idolpx/meatloaf-archived/data/.save/README

Save Folder

Cached Disk Images
Modified Disk Images
Virtual Printer Files
Favorite Sites
Recent Sites
Application Settings
