idolpx/meatloaf-archived/data/.sys/README

System Files

devices.db
file browser programs
device roms
help.txt
