idolpx/meatloaf-archived/data/.sys/help.md

``` ASCII
  ███▄ ▄███▓▓█████ ▄▄▄     ▄▄▄█████▓
 ▓██▒▀█▀ ██▒▓█   ▀▒████▄   ▓  ██▒ 
 ▓██    ▓██░▒███  ▒██  ▀█▄ ▒ ▓██░
 ▒██    ▒██ ▒▓█  ▄░██▄▄▄▄██░ ▓██▓
▒▒██▒   ░██▒░▒████ ▓█   ▓██  ▒██▒
░░ ▒░   ░  ░░░ ▒░  ▒▒   ▓▒█  ▒ ░░
  ██▓    ▒█████   ▄▄▄        █████
▒▓██▒   ▒██▒  ██▒▒████▄    ▓██    
░▒██░   ▒██░  ██▒▒██  ▀█▄  ▒████  
 ▒██░   ▒██   ██░░██▄▄▄▄██ ░▓█▒   
 ░██████░ ████▓▒░ ▓█   ▓██▒░▒█░   
 ░ ▒░▓  ░ ▒░▒░▒░  ▒▒   ▓▒█░ ▒ ░   
 ░ ░ ▒    ░ ▒ ▒░   ░   ▒▒ ░ ░     
   ░ ░  ░ ░ ░ ▒    ░   ▒    ░ ░   
     ░      ░ ░        ░  ░ 
```

# Basic Meatloaf Commands

/mode {modem | shell}
Change command mode
modem = Modem emulation mode
shell = Shell command line mode

/help modem
/help drive
/help printer
/help network
/help device
