idolpx/meatloaf-archived/docs/windows-dev.md

# Windows Dev Environment Setup

1. Install "git" for windows<br/>
	 *It's fine to take all default settings.*<br/>
	 
	 > https://git-scm.com/download/win

2. Open a command prompt and change directory to the folder 
	 where you want to download the Meatloaf firmware.<br/>
	 Enter the following command.
	
	 > git clone https://github.com/idolpx/meatloaf.git
	
	 The firmware source code will be downloaded and put into a sub directory named "meatloaf".
	 Change into the directory and copy the platformio.ini.sample file to platformio.ini.
	
	 > cd meatloaf
	 
	 > copy platformio.ini.sample platformio.ini
	
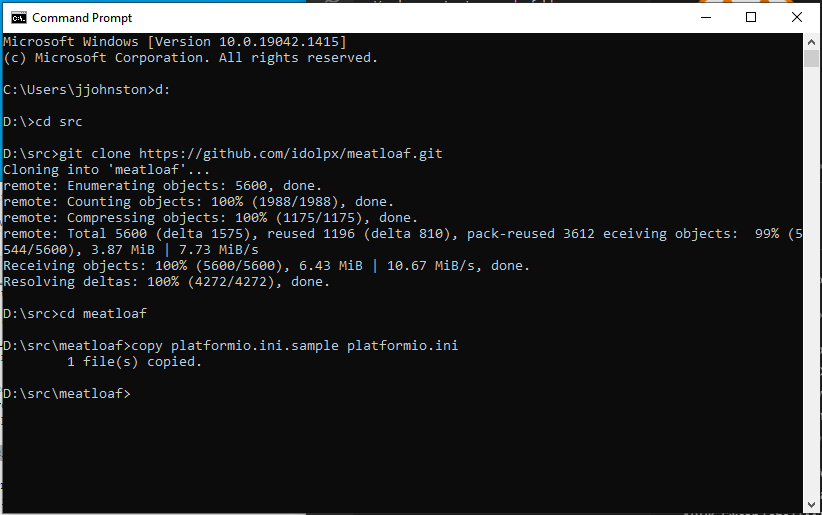
[picture p3: docs/git-meatloaf.png]
git-meatloaf
	
	
3. Install Visual Studio Code<br/>
	 Take default options during setup.<br/>
	 *(I also check off the extra options for adding the 
	 "Open with Code" context menu option for files and folders.)*<br/>
	 
	 > https://code.visualstudio.com/Download
	 
	 Launch VS Code and click on the "Extensions" icon in the side menu.<br/>
	 Search for "Git Graph" and select it and install it.<br/>
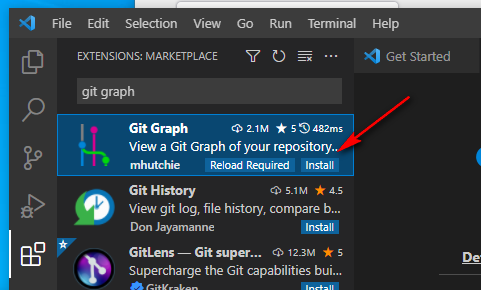
[picture p4: docs/vsc-gitgraph.png]
vsc-gitgraph
	 
	 
	 Search for "PlatformIO" and select it and install it.<br/>
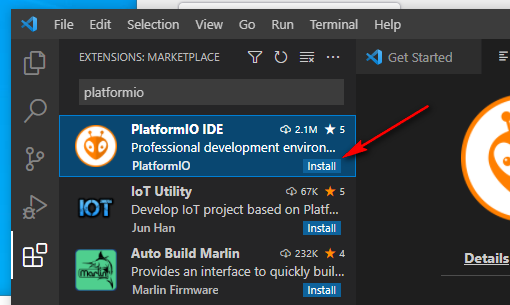
[picture p5: docs/vsc-platformio.png]
vsc-platformio
	 
	
4. Open the Meatloaf folder in VS Code.<br/>
	 Click "File/Open Folder" and browse to select the "meatloaf" folder that was created earlier.
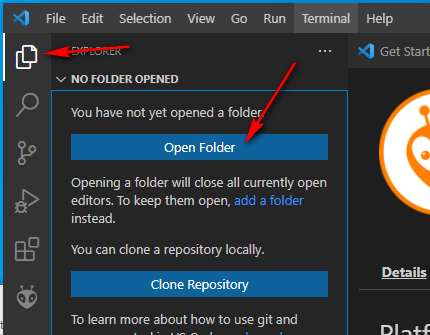
[picture p6: docs/vsc-openfolder.png]
vsc-openfolder
	 
	
5. Edit "platformio.ini" by uncommenting and editing the windows options for upload and monitor port.
	 Comment out the Linux and Mac options if they are not already.
	 Save the file.
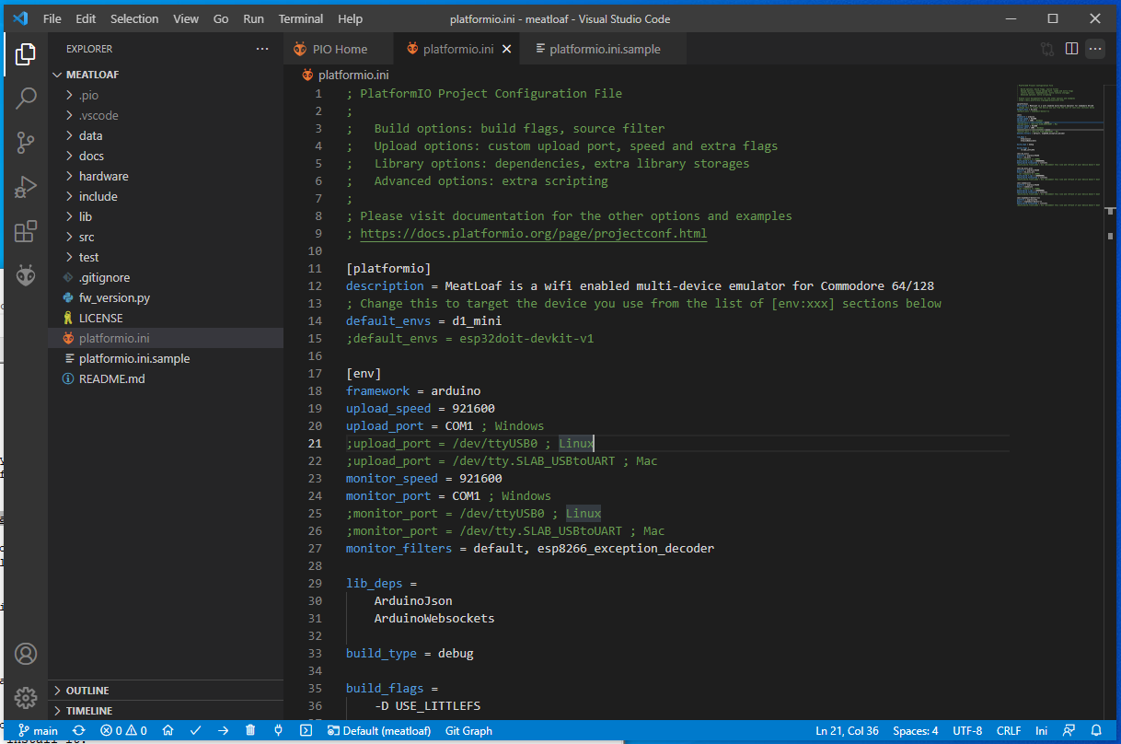
[picture p7: docs/vsc-editini.png]
vsc-editini
	 
	
6. Compile the firmware.<br/>
	 The easiest way to do this is to hit the "check" icon in the status bar.<br/>
	 *(The first time you build it will take a long time. It has to install the platform tools and all dependancies required for the build process.)*<br/>
	 pio-build-1
	 <br/>
	 You can also use the build option under Project Tasks in the PlatformIO icon from the side menu.
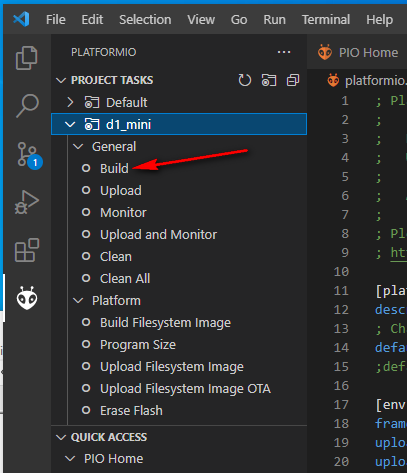
[picture p8: docs/pio-build-2.png]
pio-build-2
	 
	 <br/>
	 Success!!!<br/>
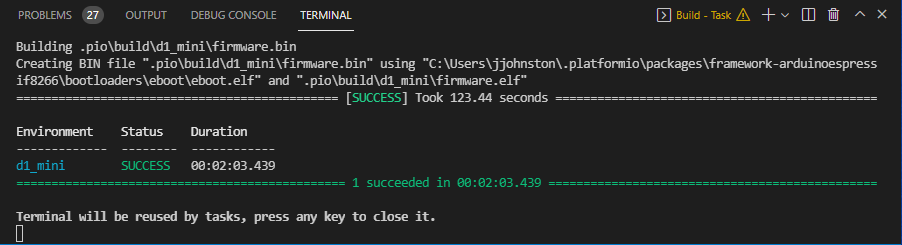
[picture p9: docs/vsc-piobuildsuccess.png]
vsc-piobuildsuccess
	 
	
7. Upload the firmware.<br/>
	 You can use the "right arrow" in the status bar to upload the firmware to your ESP module.
	 The "Upload" option is also available under Project Tasks in the PlatformIO icon from the side menu.
	
8. Build and Upload Filesystem Image<br/>
	 This task is available under Project Tasks in the PlatformIO icon from the side menu.

## Using Git Graph

1. Click the "Source Control" icon from the side menu.
2. Click the "View Git Graph (git log)" button to the right of "SOURCE CONTROL".
	 When viewing the graph you can switch see all commits to all branches of the code.
	 You can right click on a branch label to checkout that branch.<br/>
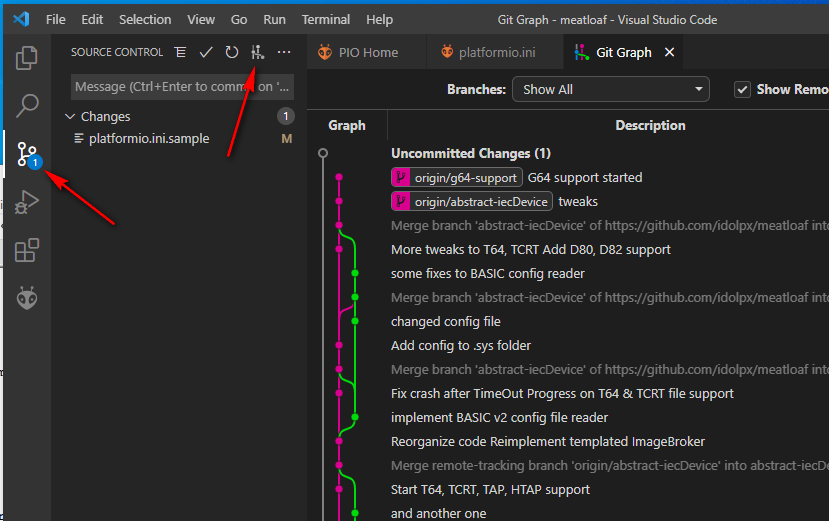
[picture p10: docs/vsc-showgitgraph.png]
vsc-showgitgraph
	 <br/>
	 <br/>
	 You can also switch branches by activating the menu dropdown list by clicking the 
	 current branch label at the far left of the status bar.<br/>
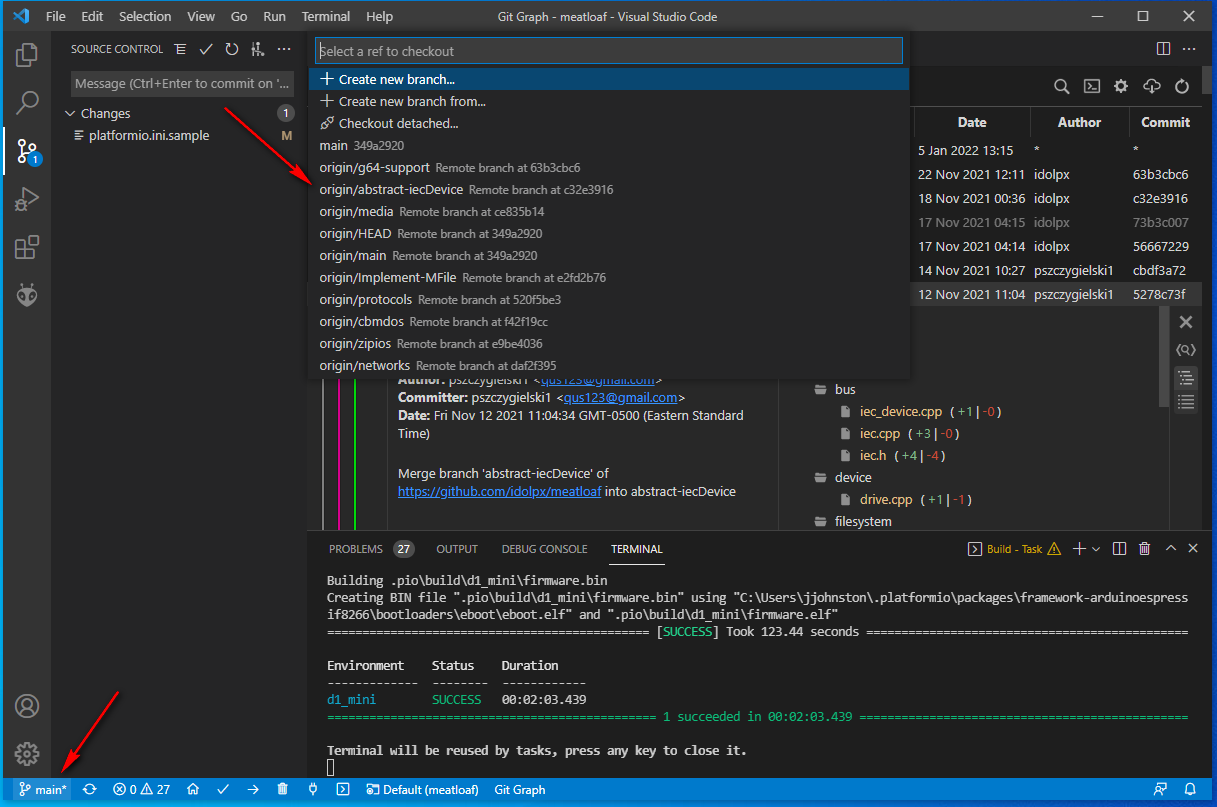
[picture p11: docs/vsc-changebranch.png]
vsc-changebranch
	 <br/>
	 <br/>
	 To switch to a specific commit, right click on a the commit in the graph.
	 Then select "Reset current branch to this Commit..." from the menu.<br/>
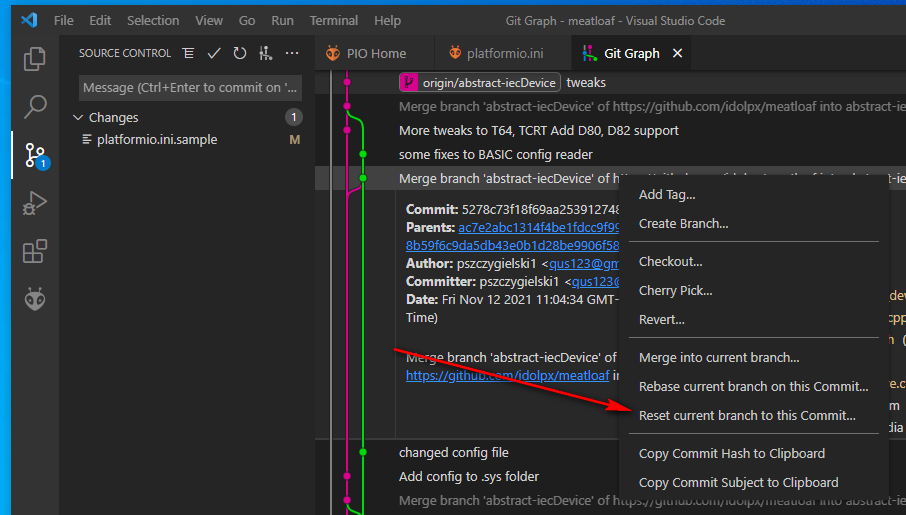
[picture p12: docs/vsc-resettocommit.png]
vsc-resettocommit
	 <br/>
	 <br/>
