idolpx/meatloaf-archived/docs/meatloaf64-svr.png

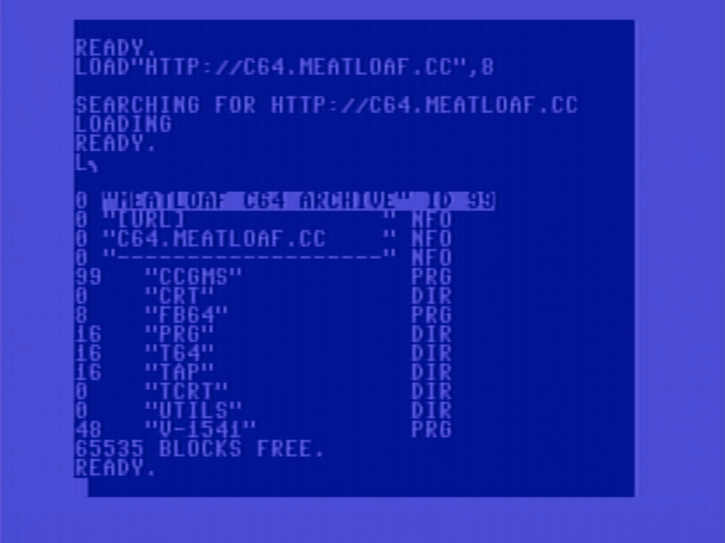
docs/meatloaf64-svr.png
