idolpx/meatloaf-archived/docs/teosweeann-5v.png

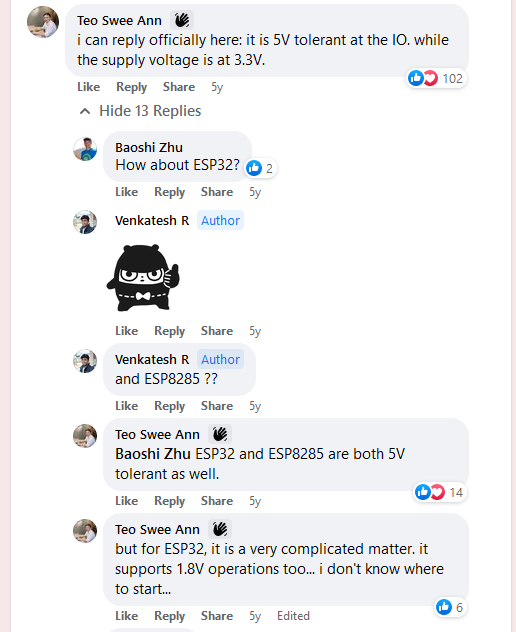
docs/teosweeann-5v.png
