idolpx/meatloaf-archived/docs/teosweeann.png

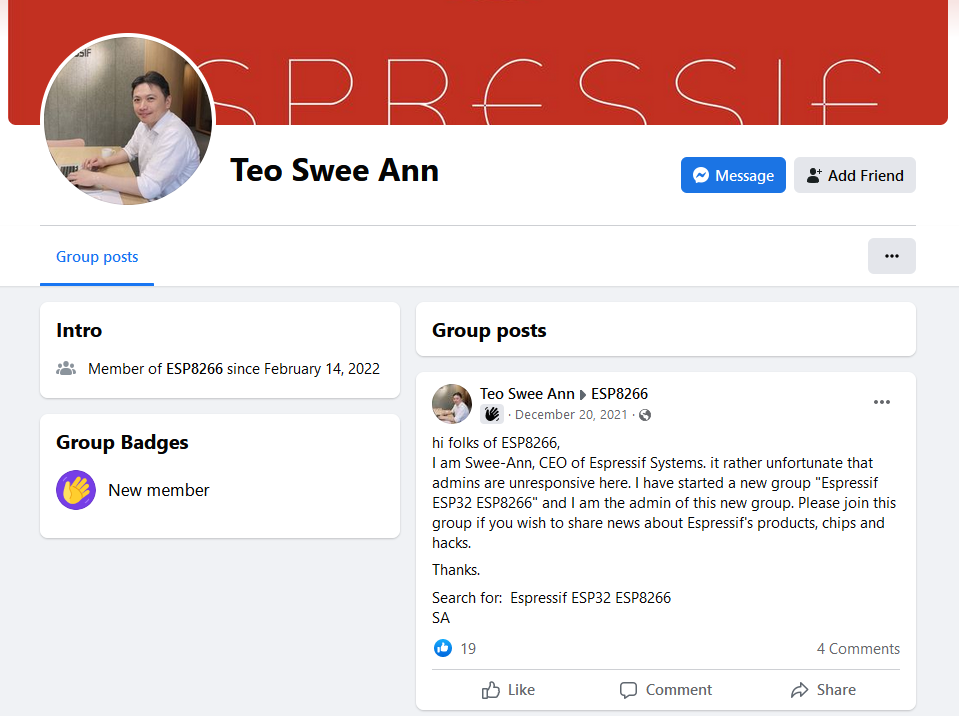
docs/teosweeann.png
