idolpx/meatloaf-archived/docs/vsc-openfolder-2.png

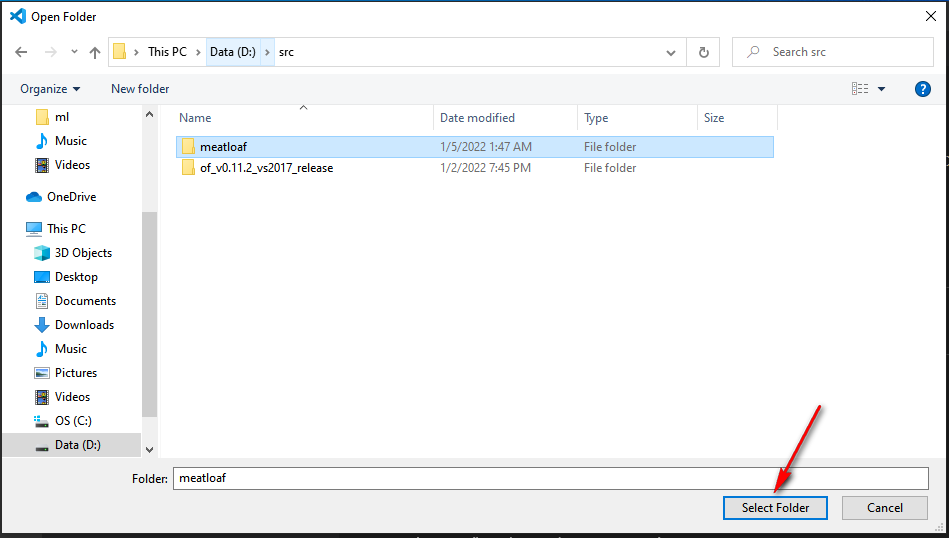
docs/vsc-openfolder-2.png
