idolpx/meatloaf-archived/hardware/meatloaf.drive.modem.1.pdf

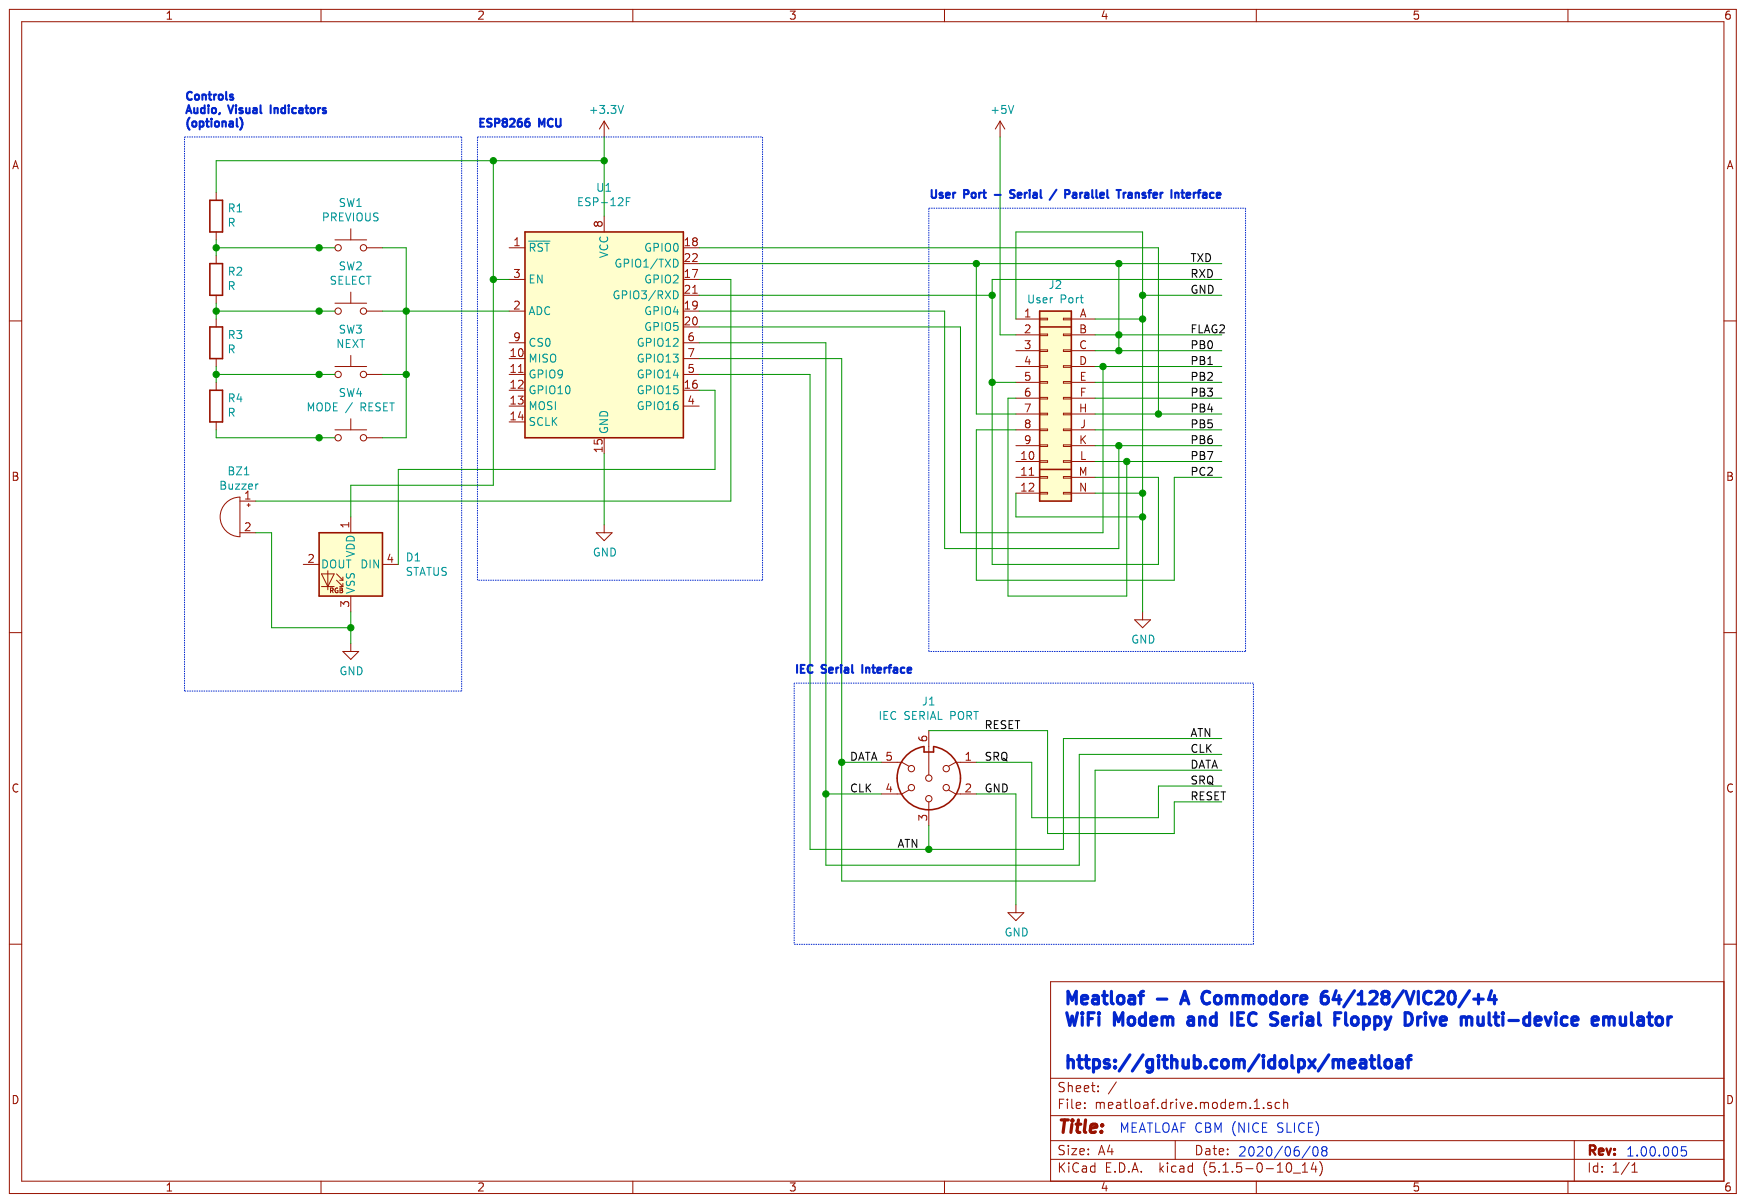
[picture p17: page 1]
