idolpx/meatloaf-archived/hardware/meatloaf.drive.modem.1/meatloaf.drive.modem.1.kicad_sch

## KiCad design hardware/meatloaf.drive.modem.1/meatloaf.drive.modem.1.kicad_sch (2022-02-19)

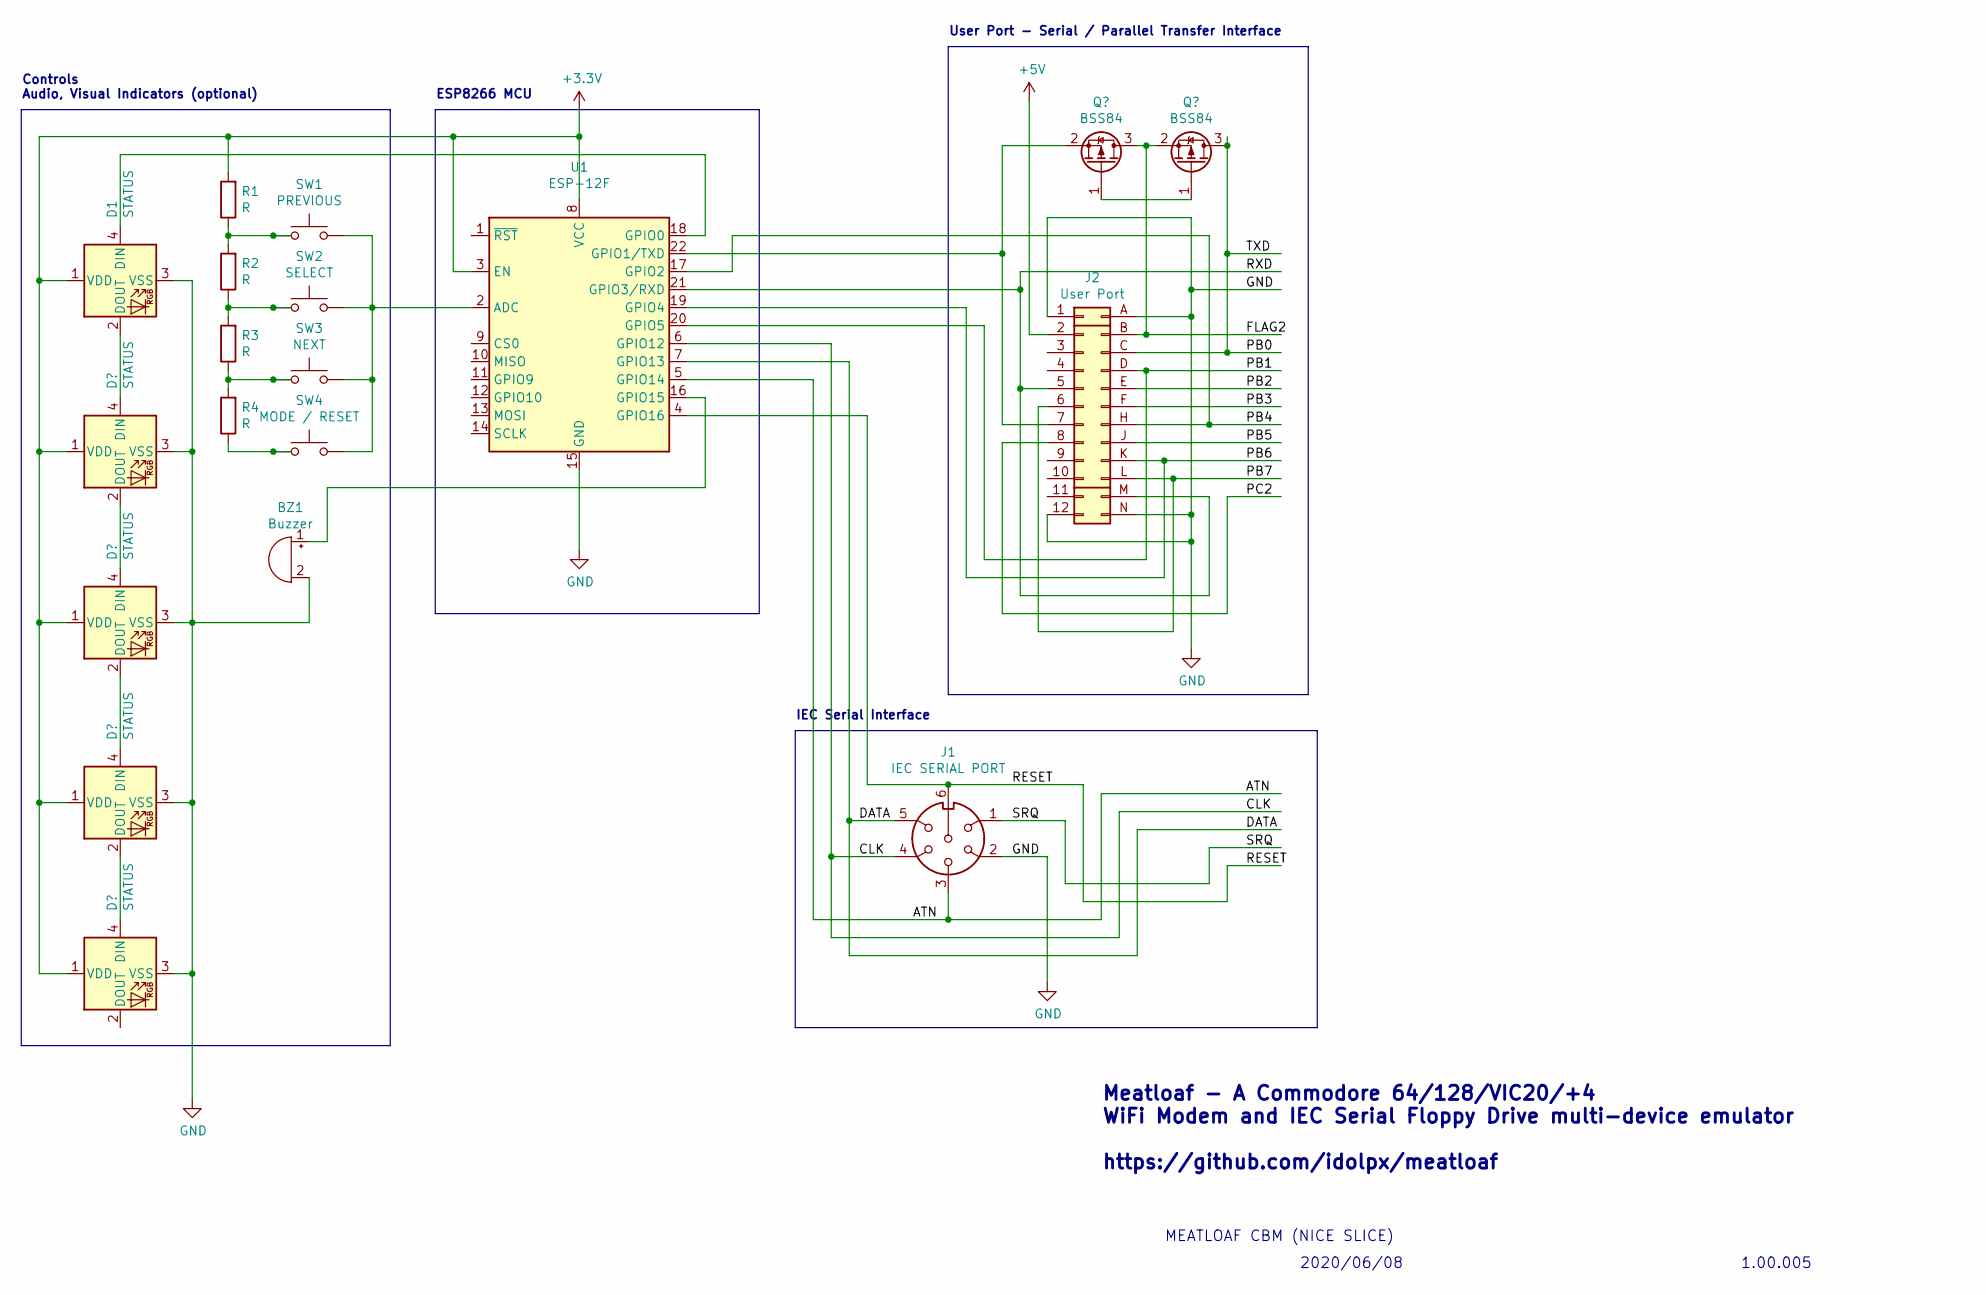
[picture p18: schematic meatloaf.drive.modem.1.kicad_sch]

Parts:
BZ1: Buzzer
D1: STATUS; LED_WS2812B_PLCC4_5.0x5.0mm_P3.2mm
J1: IEC SERIAL PORT
J2: User Port
R1, R2, R3, R4: R
SW1: PREVIOUS
SW2: SELECT
SW3: NEXT
SW4: MODE / RESET
U1: ESP-12F; ESP-12E

Connections:
+3.3V: D1.1 (VDD), R1.2, U1.3 (EN), U1.8 (VCC)
ATN: J1.3, U1.5 (GPIO14)
CLK: J1.4, U1.6 (GPIO12)
DATA: J1.5, U1.7 (GPIO13)
FLAG2: J2.B
GND: BZ1.2 (+), D1.3 (VSS), J1.2, J2.1, J2.12, J2.A, J2.N, U1.15 (GND)
unnamed: BZ1.1 (-), U1.16 (GPIO15)
unnamed: D1.4 (DIN), U1.18 (GPIO0)
unnamed: J2.7, U1.22 (GPIO1/TXD)
unnamed: R1.1, R2.2, SW1.1 (A), SW1.2 (A)
unnamed: R2.1, R3.2, SW2.1 (A), SW2.2 (A)
unnamed: R3.1, R4.2, SW3.1 (A), SW3.2 (A)
unnamed: R4.1, SW4.1 (A), SW4.2 (A)
unnamed: SW1.3 (B), SW1.4 (B), SW2.3 (B), SW2.4 (B), SW3.3 (B), SW3.4 (B), SW4.3 (B), SW4.4 (B), U1.2 (ADC)
PB0: J2.C
PB1: J2.D, U1.20 (GPIO5)
PB2: J2.E
PB3: J2.F
PB4: J2.H, U1.17 (GPIO2)
PB5: J2.J
PB6: J2.K, U1.19 (GPIO4)
PB7: J2.6, J2.L
PC2: J2.8
RESET: J1.6, U1.4 (GPIO16)
RXD: J2.5, J2.M, U1.21 (GPIO3/RXD)
SRQ: J1.1

Notes on the sheet:
1.00.005
Meatloaf - A Commodore 64/128/VIC20/+4 WiFi Modem and IEC Serial Floppy Drive multi-device emulator https://github.com/idolpx/meatloaf
IEC Serial Interface
2020/06/08
ESP8266 MCU
Controls Audio, Visual Indicators (optional)
MEATLOAF CBM (NICE SLICE)
User Port - Serial / Parallel Transfer Interface
