idolpx/meatloaf-archived/src/IECBus/iec.cpp

// Meatloaf - A Commodore 64/128 multi-device emulator
// https://github.com/idolpx/meatloaf
// Copyright(C) 2020 James Johnston
//
// This file is part of Meatloaf but adapted for use in the FujiNet project
// https://github.com/FujiNetWIFI/fujinet-platformio
// 
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
#include "iec.h"

using namespace CBM;

iecBus::iecBus() : m_state(noFlags)
{
} // ctor

// Set all IEC_signal lines in the correct mode for power up state
bool iecBus::init()
{
	// the I/O signaling method used by this low level driver uses two states:
	// PULL state is pin set to GPIO_MODE_OUTPUT with the output driving DIGI_LOW (0V)
	// RELEASE state is pin set to GPIO_MODE_INPUT so it doesn't drive the bus
	// and it allows the C64 pullup to do its job

	// The CLOCK and DATA lines are bidirectional
	// The ATN line is input only for peripherals
	// The SQR line is output only for peripherals

	// set up IO states
	pull(IEC_PIN_ATN);
	pull(IEC_PIN_CLK);
	pull(IEC_PIN_DATA);
	pull(IEC_PIN_SRQ);

//#ifdef RESET_C64
//	release(IEC_PIN_RESET);	// only early C64's could be reset by a slave going high.
//#endif

	// initial pin modes in GPIO
	set_pin_mode(IEC_PIN_ATN, INPUT);
	set_pin_mode(IEC_PIN_CLK, INPUT);
	set_pin_mode(IEC_PIN_DATA, INPUT);	
	set_pin_mode(IEC_PIN_SRQ, INPUT);
#ifdef SPLIT_LINES
	set_pin_mode(IEC_PIN_CLK_IN, INPUT);
	set_pin_mode(IEC_PIN_DATA_IN, INPUT);
#endif

	m_state = noFlags;

	return true;
} // init



// (Jim Butterfield - Compute! July 1983 - "HOW THE VIC/64 SERIAL BUS WORKS")
// STEP 1: READY TO SEND (We are listener now)
// Sooner or later, the talker will want to talk, and send a character. 
// When it's ready to go, it releases the Clock line to false.  This signal change might be 
// translated as "I'm ready to send a character." The listener must detect this and respond, 
// but it doesn't have to do so immediately. The listener will respond  to  the  talker's  
// "ready  to  send"  signal  whenever  it  likes;  it  can  wait  a  long  time.    If  it's  
// a printer chugging out a line of print, or a disk drive with a formatting job in progress, 
// it might holdback for quite a while; there's no time limit. 
uint8_t iecBus::receiveByte(void)
{
	m_state = noFlags;

	// Sample ATN and set flag to indicate SELECT or DATA mode
	if(status(IEC_PIN_ATN) == pulled)
		m_state or_eq atnFlag;

	// Talker ready to send
	if (timeoutWait(IEC_PIN_CLK, released))
	{
		Debug_println("receiveByte: talker ready to send");
		return -1;
	}

	// STEP 2: READY FOR DATA (We are listener now)
	// When  the  listener  is  ready  to  listen,  it  releases  the  Data  
	// line  to  false.    Suppose  there  is  more  than one listener.  The Data line will go false 
	// only when all listeners have released it - in other words, when  all  listeners  are  ready  
	// to  accept  data.  What  happens  next  is  variable.     
	release(IEC_PIN_DATA);

	// Wait for other listeners to be ready
	if (timeoutWait(IEC_PIN_DATA, released))
	{
		Debug_println("receiveByte: wait for all listeners to be ready");
		return -1;
	}

	// Either  the  talker  will pull the 
	// Clock line back to true in less than 200 microseconds - usually within 60 microseconds - or it  
	// will  do  nothing.    The  listener  should  be  watching,  and  if  200  microseconds  pass  
	// without  the Clock line going to true, it has a special task to perform: note EOI.
	uint8_t n = 0;
	while ((status(IEC_PIN_CLK) == released) && (n < 20))
	{
		delayMicroseconds(10);  // this loop should cycle in about 10 us...
		n++;
	}

	if (n >= TIMING_EOI_THRESH)
	{

		// INTERMISSION: EOI (We are listener now)
		// If the Ready for Data signal isn't acknowledged by the talker within 200 microseconds, the 
		// listener knows  that  the  talker  is  trying  to  signal  EOI.    EOI,  which  formally  
		// stands  for  "End  of  Indicator," means  "this  character  will  be  the  last  one."    
		// If  it's  a  sequential  disk  file,  don't  ask  for  more:  there will be no more.  If it's 
		// a relative record, that's the end of the record.  The character itself will still be coming, but 
		// the listener should note: here comes the last character. So if the listener sees the 200 microsecond  
		// time-out,  it  must  signal  "OK,  I  noticed  the  EOI"  back  to  the  talker,    I  does  this  
		// by pulling  the  Data  line  true  for  at  least  60  microseconds,  and  then  releasing  it.  
		// The  talker  will  then revert to transmitting the character in the usual way; within 60 microseconds 
		// it will pull the Clock line  true,  and  transmission  will  continue.  At  this point,  the  Clock  
		// line  is  true  whether  or  not  we have gone through the EOI sequence; we're back to a common 
		// transmission sequence.

		m_state or_eq eoiFlag; // or_eq, |=

		// Acknowledge by pull down data more than 60 us
		pull(IEC_PIN_DATA);
		delayMicroseconds(TIMING_BIT);
		release(IEC_PIN_DATA);

		// talker should pull clock in response
		if (timeoutWait(IEC_PIN_CLK, pulled))
		{
			Debug_println("receiveByte: talker should pull clk to continue EOI");
			return -1;
		}
			
	}

	// STEP 3: SENDING THE BITS (We are listener now)
	// The talker has eight bits to send.  They will go out without handshake; in other words, 
	// the listener had better be there to catch them, since the talker won't wait to hear from the listener.  At this 
	// point, the talker controls both lines, Clock and Data.  At the beginning of the sequence, it is holding the 
	// Clock true, while the Data line is released to false.  the Data line will change soon, since we'll send the data 
	// over it. The eights bits will go out from the character one at a time, with the least significant bit going first.  
	// For example, if the character is the ASCII question mark, which is  written  in  binary  as  00011111,  the  ones  
	// will  go out  first,  followed  by  the  zeros.  Now,  for  each bit, we set the Data line true or false according 
	// to whether the bit is one or zero.  As soon as that's set, the Clock line is released to false, signalling "data ready."  
	// The talker will typically have a bit in  place  and  be  signalling  ready  in  70  microseconds  or  less.  Once  
	// the  talker  has  signalled  "data ready," it will hold the two lines steady for at least 20 microseconds timing needs 
	// to be increased to 60  microseconds  if  the  Commodore  64  is  listening,  since  the  64's  video  chip  may  
	// interrupt  the processor for 42 microseconds at a time, and without the extra wait the 64 might completely miss a 
	// bit. The listener plays a passive role here; it sends nothing, and just watches.  As soon as it sees the Clock line 
	// false, it grabs the bit from the Data line and puts it away.  It then waits for the clock line to go true, in order 
	// to prepare for the next bit. When the talker figures the data has been held for a sufficient  length  of  time,  it  
	// pulls  the  Clock  line true  and  releases  the  Data  line  to  false.    Then  it starts to prepare the next bit.

	// Get the bits, sampling on clock rising edge, logic 0,0V to logic 1,5V:
#if defined(ESP8266)
	ESP.wdtFeed();
#endif
	uint8_t data = 0;
	set_pin_mode(IEC_PIN_DATA, INPUT);
	for (n = 0; n < 8; n++)
	{
		data >>= 1;

		// wait for bit to be ready to read
		if (timeoutWait(IEC_PIN_CLK, released)) // look for rising edge
		{
			Debug_println("receiveByte: wait for ready to read");
			return -1;
		}

		// get bit
		data or_eq (get_bit(IEC_PIN_DATA) ? (1 << 7) : 0); // read bit and shift in LSB first

		// wait for talker to finish sending bit
		if (timeoutWait(IEC_PIN_CLK, pulled)) // wait for falling edge
		{
			Debug_printf("receiveByte: wait for talker to finish sending (%d) bit [%d] (CLOCK)\r\n", n, data);
			return -1;
		}
	}
	delayMicroseconds(TIMING_BIT);

	// STEP 4: FRAME HANDSHAKE (We are listener now)
	// After the eighth bit has been sent, it's the listener's turn to acknowledge.  At this moment, the Clock line  is  true  
	// and  the  Data  line  is  false.    The  listener  must  acknowledge  receiving  the  byte  OK  by pulling the Data 
	// line to true. The talker is now watching the Data line.  If the listener doesn't pull the  Data  line  true  within  
	// one  millisecond  -  one  thousand  microseconds  -  it  will  know  that something's wrong and may alarm appropriately.

	// Acknowledge byte received
	pull(IEC_PIN_DATA);

	// STEP 5: START OVER (We are listener now)
	// We're  finished,  and  back  where  we  started.    The  talker  is  holding  the  Clock  line  true,  
	// and  the listener is holding the Data line true. We're ready for step 1; we may send another character - unless EOI has 
	// happened. If EOI was sent or received in this last transmission, both talker and listener "letgo."  After a suitable pause, 
	// the Clock and Data lines are released to false and transmission stops.
	// NOTE: This does not seem to hold true for the listener. Listener remains pulling data after EOI (James Johnston)

	// if(m_state bitand eoiFlag)
	// {
	// 	// EOI Received
	// 	delayMicroseconds(TIMING_STABLE_WAIT);
	// 	release(IEC_PIN_CLK);
	// 	release(IEC_PIN_DATA);
	// }

	return data;
} // receiveByte


// (Jim Butterfield - Compute! July 1983 - "HOW THE VIC/64 SERIAL BUS WORKS")
// STEP 1: READY TO SEND (We are talker now)
// Sooner or later, the talker will want to talk, and send a character. 
// When it's ready to go, it releases the Clock line to false.  This signal change might be 
// translated as "I'm ready to send a character." The listener must detect this and respond, 
// but it doesn't have to do so immediately. The listener will respond  to  the  talker's  
// "ready  to  send"  signal  whenever  it  likes;  it  can  wait  a  long  time.    If  it's  
// a printer chugging out a line of print, or a disk drive with a formatting job in progress, 
// it might holdback for quite a while; there's no time limit. 
bool iecBus::sendByte(uint8_t data, bool signalEOI)
{
	// Say we're ready
	release(IEC_PIN_CLK);

	// Wait for listener to be ready
	// STEP 2: READY FOR DATA (We are talker now)
	// When  the  listener  is  ready  to  listen,  it  releases  the  Data  
	// line  to  false.    Suppose  there  is  more  than one listener.  The Data line will go false 
	// only when all listeners have released it - in other words, when  all  listeners  are  ready  
	// to  accept  data.  What  happens  next  is  variable. 
	if (timeoutWait(IEC_PIN_DATA, released))
	{
		Debug_printf("sendByte: wait for listener to be ready\r\n");
		return -1;
	}

	// Either  the  talker  will pull the 
	// Clock line back to true in less than 200 microseconds - usually within 60 microseconds - or it  
	// will  do  nothing.    The  listener  should  be  watching,  and  if  200  microseconds  pass  
	// without  the Clock line going to true, it has a special task to perform: note EOI.
	if (signalEOI == true)
	{
		// INTERMISSION: EOI (We are talker now)
		// If the Ready for Data signal isn't acknowledged by the talker within 200 microseconds, the 
		// listener knows  that  the  talker  is  trying  to  signal  EOI.    EOI,  which  formally  
		// stands  for  "End  of  Indicator," means  "this  character  will  be  the  last  one."    
		// If  it's  a  sequential  disk  file,  don't  ask  for  more:  there will be no more.  If it's 
		// a relative record, that's the end of the record.  The character itself will still be coming, but 
		// the listener should note: here comes the last character. So if the listener sees the 200 microsecond  
		// time-out,  it  must  signal  "OK,  I  noticed  the  EOI"  back  to  the  talker,    I  does  this  
		// by pulling  the  Data  line  true  for  at  least  60  microseconds,  and  then  releasing  it.  
		// The  talker  will  then revert to transmitting the character in the usual way; within 60 microseconds 
		// it will pull the Clock line  true,  and  transmission  will  continue.  At  this point,  the  Clock  
		// line  is  true  whether  or  not  we have gone through the EOI sequence; we're back to a common 
		// transmission sequence.

		// Signal eoi by waiting 200 us
		delayMicroseconds(TIMING_EOI_WAIT);

		// get eoi acknowledge: pull
		if (timeoutWait(IEC_PIN_DATA, pulled))
		{
			Debug_printf("sendByte: wait for listener acknowledge EOI (data pull)\r\n");
			return -1;
		}

		// get eoi acknowledge: release
		if (timeoutWait(IEC_PIN_DATA, released))
		{
			Debug_printf("sendByte: wait for listener acknowledge EOI (data release)\r\n");
			return -1;
		}
	}
	else
	{
		delayMicroseconds(TIMING_NO_EOI);		
	}

	// STEP 3: SENDING THE BITS (We are talker now)
	// The talker has eight bits to send.  They will go out without handshake; in other words, 
	// the listener had better be there to catch them, since the talker won't wait to hear from the listener.  At this 
	// point, the talker controls both lines, Clock and Data.  At the beginning of the sequence, it is holding the 
	// Clock true, while the Data line is released to false.  the Data line will change soon, since we'll sendthe data 
	// over it. The eights bits will go out from the character one at a time, with the least significant bit going first.  
	// For example, if the character is the ASCII question mark, which is  written  in  binary  as  00011111,  the  ones  
	// will  go out  first,  followed  by  the  zeros.  Now,  for  each bit, we set the Data line true or false according 
	// to whether the bit is one or zero.  As soon as that's set, the Clock line is released to false, signalling "data ready."  
	// The talker will typically have a bit in  place  and  be  signalling  ready  in  70  microseconds  or  less.  Once  
	// the  talker  has  signalled  "data ready," it will hold the two lines steady for at least 20 microseconds timing needs 
	// to be increased to 60  microseconds  if  the  Commodore  64  is  listening,  since  the  64's  video  chip  may  
	// interrupt  the processor for 42 microseconds at a time, and without the extra wait the 64 might completely miss a 
	// bit. The listener plays a passive role here; it sends nothing, and just watches.  As soon as it sees the Clock line 
	// false, it grabs the bit from the Data line and puts it away.  It then waits for the clock line to go true, in order 
	// to prepare for the next bit. When the talker figures the data has been held for a sufficient  length  of  time,  it  
	// pulls  the  Clock  line true  and  releases  the  Data  line  to  false.    Then  it starts to prepare the next bit.
	// NOTE: delay between bits needs to be 75us minimum from my observations (James Johnston)

	// Send the bits, sampling on clock rising edge, logic 0,0V to logic 1,5V:
#if defined(ESP8266)
	ESP.wdtFeed();
#endif	
	set_pin_mode(IEC_PIN_DATA, OUTPUT);
	for (uint8_t n = 0; n < 8; n++)
	{
		// tell listener to wait
		pull(IEC_PIN_CLK);

		// set data bit
		set_bit(IEC_PIN_DATA, (data & 1));
		delayMicroseconds(TIMING_BIT);

		// tell listener bit is ready to read
		release(IEC_PIN_CLK);
		delayMicroseconds(TIMING_BIT);

		data >>= 1; // get next bit
	}

	pull(IEC_PIN_CLK);	// pull clock cause we're done
	release(IEC_PIN_DATA); // release data because we're done

	// STEP 4: FRAME HANDSHAKE (We are talker now)
	// After the eighth bit has been sent, it's the listener's turn to acknowledge.  At this moment, the Clock line  is  true  
	// and  the  Data  line  is  false.    The  listener  must  acknowledge  receiving  the  byte  OK  by pulling the Data 
	// line to true. The talker is now watching the Data line.  If the listener doesn't pull the  Data  line  true  within  
	// one  millisecond  -  one  thousand  microseconds  -  it  will  know  that something's wrong and may alarm appropriately.

	// Wait for listener to accept data
	if (timeoutWait(IEC_PIN_DATA, pulled))
	{
		Debug_printf("sendByte: wait for listener to accept data\r\n");
		return -1;
	}

	// STEP 5: START OVER (We are talker now)
	// We're  finished,  and  back  where  we  started.    The  talker  is  holding  the  Clock  line  true,  
	// and  the listener is holding the Data line true. We're ready for step 1; we may send another character - unless EOI has 
	// happened. If EOI was sent or received in this last transmission, both talker and listener "letgo."  After a suitable pause, 
	// the Clock and Data lines are released to false and transmission stops. 

	if (signalEOI == true)
	{
		// EOI Sent
		delayMicroseconds(TIMING_STABLE_WAIT);
		release(IEC_PIN_CLK);
		release(IEC_PIN_DATA);
	}

	return true;
} // sendByte


// (Jim Butterfield - Compute! July 1983 - "HOW THE VIC/64 SERIAL BUS WORKS")
// TURNAROUND
// An unusual sequence takes place following ATN if the computer wishes the remote device to
// become a talker. This will usually take place only after a Talk command has been sent.
// Immediately after ATN is released, the selected device will be behaving like a listener. After all, it's
// been listening during the ATN cycle, and the computer
// has been a talker. At this instant, we have "wrong way" logic; the device is holding down the Data
// line, and the computer is holding the Clock line. We must turn this around. Here's the sequence:
// the computer quickly realizes what's going on, and pulls the Data line to true (it's already there), as
// well as releasing the Clock line to false. The device waits for this: when it sees the Clock line go
// true [sic], it releases the Data line (which stays true anyway since the computer is now holding it down)
// and then pulls down the Clock line. We're now in our starting position, with the talker (that's the
// device) holding the Clock true, and the listener (the computer) holding the Data line true. The
// computer watches for this state; only when it has gone through the cycle correctly will it be ready
// to receive data. And data will be signalled, of course, with the usual sequence: the talker releases
// the Clock line to signal that it's ready to send.
bool iecBus::turnAround(void)
{
	// Wait until clock is released
	if (timeoutWait(IEC_PIN_CLK, released))
	{
		Debug_println("\r\nturnAround: timeout");
		return false;
	}

	release(IEC_PIN_DATA);
	delayMicroseconds(TIMING_BIT);
	pull(IEC_PIN_CLK);
	delayMicroseconds(TIMING_BIT);

	Debug_println("\r\nturnAround: complete");
	return true;
} // turnAround


// this routine will set the direction on the bus back to normal
// (the way it was when the computer was switched on)
bool iecBus::undoTurnAround(void)
{
	pull(IEC_PIN_DATA);
	delayMicroseconds(TIMING_BIT);
	release(IEC_PIN_CLK);
	delayMicroseconds(TIMING_BIT);

	// wait until the computer pulls the clock line
	if (timeoutWait(IEC_PIN_CLK, pulled))
	{
		Debug_printf("\r\nundoTurnAround: timeout");
		return false;
	}

	Debug_printf("\r\nundoTurnAround: complete");
	return true;
} // undoTurnAround

// timeoutWait returns true if timed out
bool iecBus::timeoutWait(uint8_t pin, IECline state)
{
	
	uint16_t t = 0;

	while(t < TIMEOUT) 
	{
		// Check the waiting condition:
		if(status(pin) == state)
		{
			// Got it!  Continue!
			return false;
		}
		delayMicroseconds(1); // The aim is to make the loop at least 3 us
		t++;

#if defined(ESP8266)
		ESP.wdtFeed();
#endif		
	}

	// If down here, we have had a timeout.
	// Release lines and go to inactive state with error flag
	release(IEC_PIN_CLK);
	release(IEC_PIN_DATA);

	m_state = errorFlag;

	// Wait for ATN release, problem might have occured during attention
	while(status(IEC_PIN_ATN) == pulled);

	// Note: The while above is without timeout. If ATN is held low forever,
	//       the CBM is out in the woods and needs a reset anyways.

	Debug_printf("\r\ntimeoutWait: true [%d] [%d] [%d] [%d] ", pin, state, t, m_state);
	return true;
} // timeoutWait

/******************************************************************************
 *                                                                             *
 *                               Public functions                              *
 *                                                                             *
 ******************************************************************************/

// This function checks and deals with atn signal commands
//
// If a command is recieved, the atn_cmd.string is saved in atn_cmd. Only commands
// for *this* device are dealt with.
//
// (Jim Butterfield - Compute! July 1983 - "HOW THE VIC/64 SERIAL BUS WORKS")
// ATN SEQUENCES
// When ATN is pulled true, everybody stops what they are doing. The processor will quickly pull the
// Clock line true (it's going to send soon), so it may be hard to notice that all other devices release the
// Clock line. At the same time, the processor releases the Data line to false, but all other devices are
// getting ready to listen and will each pull Data to true. They had better do this within one
// millisecond (1000 microseconds), since the processor is watching and may sound an alarm ("device
// not available") if it doesn't see this take place. Under normal circumstances, transmission now
// takes place as previously described. The computer is sending commands rather than data, but the
// characters are exchanged with exactly the same timing and handshakes as before. All devices
// receive the commands, but only the specified device acts upon it. This results in a curious
// situation: you can send a command to a nonexistent device (try "OPEN 6,6") - and the computer
// will not know that there is a problem, since it receives valid handshakes from the other devices.
// The computer will notice a problem when you try to send or receive data from the nonexistent
// device, since the unselected devices will have dropped off when ATN ceased, leaving you with
// nobody to talk to.

// Return value, see iecBus::ATNCheck definition.
iecBus::ATNCheck iecBus::checkATN(ATNCmd &atn_cmd)
{
	ATNCheck ret = ATN_IDLE;

#ifdef DEBUG_TIMING
	uint8_t pin = IEC_PIN_ATN;
	pull(pin);
	delayMicroseconds(1000); // 1000
	release(pin);
	delayMicroseconds(1000);

	pin = IEC_PIN_CLK;
	pull(pin);
	delayMicroseconds(20); // 20
	release(pin);
	delayMicroseconds(1);

	pin = IEC_PIN_DATA;
	pull(pin);
	delayMicroseconds(50); // 50
	release(pin);
	delayMicroseconds(1);

	pin = IEC_PIN_SRQ;
	pull(pin);
	delayMicroseconds(60); // 60
	release(pin);
	delayMicroseconds(1);

	pin = IEC_PIN_ATN;
	pull(pin);
	delayMicroseconds(100); // 100
	release(pin);
	delayMicroseconds(1);

	pin = IEC_PIN_CLK;
	pull(pin);
	delayMicroseconds(200); // 200
	release(pin);
	delayMicroseconds(1);
#endif

	if (status(IEC_PIN_ATN) == pulled)
	{
		// Attention line is pulled, go to listener mode and get message.
		// Being fast with the next two lines here is CRITICAL!
		pull(IEC_PIN_DATA);
		release(IEC_PIN_CLK);
		delayMicroseconds(TIMING_ATN_PREDELAY);

		// Get first ATN byte, it is either LISTEN or TALK
		ATNCommand c = (ATNCommand)receive();
		Debug_printf("\r\ncheckATN: %.2X ", c);
		if (m_state bitand errorFlag)
		{
			Debug_printf("\r\ncheckATN: get first ATN byte");
			return ATN_ERROR;
		}

		atn_cmd.code = c;

		ATNCommand cc = c;
		if (c != ATN_CODE_UNTALK && c != ATN_CODE_UNLISTEN)
		{
			// Is this a Listen or Talk command
			cc = (ATNCommand)(c bitand ATN_CODE_LISTEN);
			if (cc == ATN_CODE_LISTEN)
			{
				atn_cmd.device = c ^ ATN_CODE_LISTEN; // device specified, '^' = XOR
			}
			else
			{
				cc = (ATNCommand)(c bitand ATN_CODE_TALK);
				atn_cmd.device = c ^ ATN_CODE_TALK; // device specified
			}

			// Get the first cmd byte, the atn_cmd.code
			c = (ATNCommand)receive();
			if (m_state bitand errorFlag)
			{
				Debug_printf("\r\ncheckATN: get first cmd byte");
				return ATN_ERROR;
			}

			atn_cmd.code = c;
			atn_cmd.command = c bitand 0xF0; // upper nibble, the command itself
			atn_cmd.channel = c bitand 0x0F; // lower nibble is the channel
		}

		if (isDeviceEnabled(atn_cmd.device))
		{
			if (cc == ATN_CODE_LISTEN) // 0x20 LISTEN + device number (0-30)
			{
				ret = listen(atn_cmd);
			}
			else if (cc == ATN_CODE_TALK) // 0x40 TALK + device number (0-30)
			{
				ret = talk(atn_cmd);
			}
			else
			{
				// Either the message is not for us or insignificant, like unlisten.
				delayMicroseconds(TIMING_ATN_DELAY);
				release(IEC_PIN_DATA);
				release(IEC_PIN_CLK);

				if (cc == ATN_CODE_UNLISTEN) // 3F UNLISTEN
				{
					Debug_printf("(UNLISTEN)", cc);
				}
				if (cc == ATN_CODE_UNTALK) // 5F UNTALK
				{	
					Debug_printf("(UNTALK)", cc);
				}

				// Wait for ATN to release and quit
				while(status(IEC_PIN_ATN) == pulled);
				Debug_printf("\r\ncheckATN: ATN Released\r\n");
			}
		}

		// some delay is required before more ATN business can take place.
		delayMicroseconds(TIMING_ATN_DELAY);
	}
	// else
	// {
	// 	// No ATN, keep lines in a released state.
	// 	release(IEC_PIN_DATA);
	// 	release(IEC_PIN_CLK);
	// }

	return ret;
} // checkATN


iecBus::ATNCheck iecBus::listen(ATNCmd &atn_cmd)
{
	// Okay, we will listen.
	Debug_printf("(20 LISTEN) (%.2d DEVICE)", atn_cmd.device);


	if (atn_cmd.command == ATN_CODE_DATA) // 0x60 OPEN CHANNEL / DATA + Secondary Address / channel (0-15)
	{
		// If this 
		if (atn_cmd.channel == CMD_CHANNEL)
		{
			return receiveCommand(atn_cmd);
		}
		else
		{
			// A heapload of data might come now, too big for this context to handle so the caller handles this, we're done here.
			Debug_printf("\r\nlisten: %.2X (DATA) (%.2X COMMAND) (%.2X CHANNEL)", atn_cmd.code, atn_cmd.command, atn_cmd.channel);
			return ATN_CMD_LISTEN;			
		}
	}
	else if (atn_cmd.command == ATN_CODE_OPEN) // 0xF0 OPEN CHANNEL / DATA + Secondary Address / channel (0-15)
	{
		Debug_printf("\r\nlisten: %.2X (%.2X OPEN) (%.2X CHANNEL)", atn_cmd.code, atn_cmd.command, atn_cmd.channel);
		return receiveCommand(atn_cmd);
	}	
	else
	{
		if (atn_cmd.command == ATN_CODE_CLOSE) // 0xE0 CLOSE CHANNEL / DATA + Secondary Address / channel (0-15)
		{
			Debug_printf("\r\nlisten: %.2X (%.2X CLOSE) (%.2X CHANNEL)", atn_cmd.code, atn_cmd.command, atn_cmd.channel);
		}		
	}

	return ATN_IDLE;
}


iecBus::ATNCheck iecBus::talk(ATNCmd &atn_cmd)
{
	uint8_t i = 0;
	uint8_t c;

	// Okay, we will talk soon
	Debug_printf("(40 TALK) (%.2d DEVICE)", atn_cmd.device);
	Debug_printf("\r\ntalk: %.2X (%.2X SECOND) (%.2X CHANNEL)", atn_cmd.code, atn_cmd.command, atn_cmd.channel);

	while(status(IEC_PIN_ATN) == pulled) 
	{
		if(status(IEC_PIN_CLK) == released) 
		{
			c = receive();
			if (m_state bitand errorFlag)
				return ATN_ERROR;

			if (i >= ATN_CMD_MAX_LENGTH)
			{
				// Buffer is going to overflow, this is an error condition
				// FIXME: here we should propagate the error type being overflow so that reading error channel can give right code out.
				return ATN_ERROR;
			}
			atn_cmd.str[i++] = c;
			atn_cmd.str[i] = '\0';
			atn_cmd.strLen = i;
		}
	}

	// Now ATN has just been released, do bus turnaround
	if (not turnAround())
		return ATN_ERROR;

	// We have recieved a CMD and we should talk now:
	return ATN_CMD_TALK;
}


iecBus::ATNCheck iecBus::receiveCommand(ATNCmd &atn_cmd)
{
	uint8_t i = 0;
	uint8_t c;

	// Some other command. Record the cmd string until UNLISTEN is sent
	while(status(IEC_PIN_ATN) == released)
	{
		// Let's get the command!
		c = receive();

		if (m_state bitand errorFlag)
		{
			Debug_printf("\r\nreceiveCommand: receiving LISTEN command");
			return ATN_ERROR;
		}

		if (i >= ATN_CMD_MAX_LENGTH)
		{
			// Buffer is going to overflow, this is an error condition
			// FIXME: here we should propagate the error type being overflow so that reading error channel can give right code out.
			Debug_printf("\r\nreceiveCommand: ATN_CMD_MAX_LENGTH");
			return ATN_ERROR;
		}

		atn_cmd.str[i++] = c;
		atn_cmd.str[i] = '\0';
		atn_cmd.strLen = i;

		// Is this the end of the command? Was EOI sent?
		if (m_state bitand eoiFlag)
		{
			Debug_printf("\r\nreceiveCommand: [%s] + EOI", atn_cmd.str);
			return ATN_CMD;
		}		
	}

	return ATN_IDLE;
}

// bool iecBus::checkRESET()
// {
// 	return readRESET();
// } // checkRESET


// IEC_receive receives a byte
//
uint8_t iecBus::receive()
{
	uint8_t data;
	data = receiveByte();
	return data;
} // receive


// IEC_send sends a byte
//
bool iecBus::send(uint8_t data)
{
#ifdef DATA_STREAM
	Debug_printf("%.2X ", data);
#endif
	return sendByte(data, false);
} // send


// Same as IEC_send, but indicating that this is the last byte.
//
bool iecBus::sendEOI(uint8_t data)
{
	Debug_printf("\r\nEOI Sent!");
	if (sendByte(data, true))
	{
		//Debug_printf("true");

		// As we have just send last byte, turn bus back around
		if (undoTurnAround())
		{
			return true;
		}
	}

	//Debug_printf("false");
	return false;
} // sendEOI


// A special send command that informs file not found condition
//
bool iecBus::sendFNF()
{
	// Message file not found by just releasing lines
	release(IEC_PIN_DATA);
	release(IEC_PIN_CLK);

	// Hold back a little...
	delayMicroseconds(TIMING_FNF_DELAY);

	Debug_printf("\r\nsendFNF: true");
	return true;
} // sendFNF


bool iecBus::isDeviceEnabled(const uint8_t deviceNumber)
{
	return (enabledDevices & (1 << deviceNumber));
} // isDeviceEnabled


iecBus::IECState iecBus::state() const
{
	return static_cast<IECState>(m_state);
} // state
