idolpx/meatloaf-archived/src/IECBus/iec_device.h

// Meatloaf - A Commodore 64/128 multi-device emulator
// https://github.com/idolpx/meatloaf
// Copyright(C) 2020 James Johnston
//
// This file is part of Meatloaf but adapted for use in the FujiNet project
// https://github.com/FujiNetWIFI/fujinet-platformio
// 
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
#ifndef IECDEVICE_H
#define IECDEVICE_H

#if defined(ESP8266)

#include <ESP8266WiFi.h>
#include <ESP8266HTTPClient.h>

#if defined(USE_SPIFFS)
#include <SPIFFS.h>
#elif defined(USE_LITTLEFS)
#include <LittleFS.h>
#endif

#include "global_defines.h"
#include "MemoryInfo.h"
#include "iec.h"
#include "cbmdefines.h"
#include "Petscii.h"
#include "device_db.h"
#include "helpers.h"

enum OpenState {
	O_NOTHING,			// Nothing to send / File not found error
	O_INFO,				// User issued a reload sd card
	O_FILE,				// A program file is opened
	O_DIR,				// A listing is requested
	O_FILE_ERR,			// Incorrect file format opened
	O_SAVE_REPLACE,		// Save-with-replace is requested
	O_DEVICE_INFO,
	O_DEVICE_STATUS
};

// The base pointer of basic.
#define C64_BASIC_START 0x0801

class iecDevice
{
public:
	iecDevice(iecBus &iec, FS *fileSystem);
	virtual ~iecDevice() {}

	bool begin();

	// The handler returns the current IEC state, see the iec.hpp for possible states.
	void service(void);

private:
	void reset(void);

	void sendStatus(void);
	void sendDeviceInfo(void);
	void sendDeviceStatus(void);

	void sendListing(void);
	void sendListingHTTP(void);
	uint16_t sendHeader(uint16_t &basicPtr);
	uint16_t sendLine(uint16_t &basicPtr, uint16_t blocks, char *text);
	uint16_t sendLine(uint16_t &basicPtr, uint16_t blocks, const char *format, ...);
	uint16_t sendFooter(uint16_t &basicPtr);
	void sendFile(void);
	void sendFileHTTP(void);

	void saveFile(void);

	// handler helpers.
	void handleATNCmdCodeOpen(iecBus::ATNCmd &cmd);
	void handleATNCmdCodeDataListen(void);
	void handleATNCmdCodeDataTalk(uint8_t chan);
	void handleATNCmdClose(void);

	void handleDeviceCommand(iecBus::ATNCmd &cmd);
	void handleMeatLoafCommand(iecBus::ATNCmd &cmd);

	// our iec low level driver:
	iecBus &m_iec;

	// This var is set after an open command and determines what to send next
	byte m_openState; // see OpenState
	byte m_queuedError;

	// atn command buffer struct
	iecBus::ATNCmd &m_atn_cmd;

	FS *m_fileSystem;
	StaticJsonDocument<256> m_jsonHTTP;
	String m_lineBuffer;
	DynamicJsonDocument m_jsonHTTPBuffer;

	DeviceDB m_device;
	String m_filename;
	String m_filetype;
};

#elif defined(ESP32)

#include <WiFi.h>
#include <HTTPClient.h>

#if defined(USE_SPIFFS)
#include <SPIFFS.h>
#elif defined(USE_LITTLEFS)
#include <LittleFS.h>
#endif

#include "global_defines.h"
#include "MemoryInfo.h"
#include "iec.h"
#include "cbmdefines.h"
#include "Petscii.h"
#include "device_db.h"
#include "helpers.h"

// enum  fsType {
// 	IS_FAIL = 0xFF, 	// IFail: SD card or fat not ok
// 	IS_NATIVE = 0,		// Regular file system file state
// 	IS_D64 = 1,
// 	IS_T64 = 2,
// 	IS_M2I = 3,
// 	IS_PRG = 4,
// };

enum OpenState
{
	O_NOTHING,		// Nothing to send / File not found error
	O_INFO,			// User issued a reload sd card
	O_FILE,			// A program file is opened
	O_DIR,			// A listing is requested
	O_FILE_ERR,		// Incorrect file format opened
	O_SAVE_REPLACE, // Save-with-replace is requested
	O_DEVICE_INFO,
	O_DEVICE_STATUS
};

// The base pointer of basic.
#define C64_BASIC_START 0x0801

class iecDevice
{
public:
	iecDevice(iecBus &iec, FS *fileSystem);
	virtual ~iecDevice() {}

	bool begin();

	// The handler returns the current IEC state, see the iec.hpp for possible states.
	byte loop(void);

private:
	void reset(void);

	void sendStatus(void);
	void sendDeviceInfo(void);
	void sendDeviceStatus(void);

	void sendListing(void);
	void sendListingHTTP(void);
	uint16_t sendHeader(uint16_t &basicPtr);
	uint16_t sendLine(uint16_t &basicPtr, uint16_t blocks, char *text);
	uint16_t sendLine(uint16_t &basicPtr, uint16_t blocks, const char *format, ...);
	uint16_t sendFooter(uint16_t &basicPtr);
	void sendFile(void);
	void sendFileHTTP(void);

	void saveFile(void);

	// handler helpers.
	void handleATNCmdCodeOpen(iecBus::ATNCmd &cmd);
	void handleATNCmdCodeDataListen(void);
	void handleATNCmdCodeDataTalk(uint8_t chan);
	void handleATNCmdClose(void);

	void handleDeviceCommand(iecBus::ATNCmd &cmd);
	void handleMeatLoafCommand(iecBus::ATNCmd &cmd);

	// our iec low level driver:
	iecBus& m_iec;

	// This var is set after an open command and determines what to send next
	uint8_t m_openState; // see OpenState
	uint8_t m_queuedError;

	// atn command buffer struct
	iecBus::ATNCmd& m_atn_cmd;

	FS *m_fileSystem;
	StaticJsonDocument<256> m_jsonHTTP;
	String m_lineBuffer;
	//DynamicJsonDocument m_jsonHTTPBuffer;

	DeviceDB m_device;
	String m_filename;
	String m_filetype;
};

#endif
#endif
