idolpx/meatloaf-archived/include/petscii.h

// Pi1541 - A Commodore 1541 disk drive emulator
// Copyright(C) 2018 Stephen White
//
// This file is part of Pi1541.
// 
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
#ifndef PETSCII_H
#define PETSCII_H

static inline uint8_t ascii2petscii(uint8_t ch)
{
	if (ch > 64 && ch < 91) ch += 32; // A..Z <65..90>ASCII --> <97..122>PETSCII
	else if (ch > 96 && ch < 123) ch -= 32; // <a..z> <97..122> ASCII --> <65..90>PETSCII
	return ch;
}
static inline uint8_t petscii2ascii(uint8_t ch)
{
	if (ch > 64 && ch < 91) ch += 32;
	else if(ch > 96 && ch < 123) ch -=32 ;
	// 193..218 is also PETSCII UC
	else if (ch >=192 && ch <= 218) ch -= 128;
	return ch;
}

static inline uint8_t petscii2screen(uint8_t ch)
{
	if ((ch >= 0x40 && ch <= 0x5F) || (ch >= 0xa0 && ch <= 0xbf)) ch -= 0x40;
	else if (ch >= 0xc0 && ch <= 0xdf) ch -= 0x80;
	else if (ch <= 0x1f) ch += 0x80;
	else if ((ch >= 0x60 && ch <= 0x7F) || (ch >= 0x90 && ch <= 0x9f)) ch += 0x40;
	return ch;
}

static inline uint8_t screen2petscii(uint8_t ch)
{
	if (ch <= 0x1F || (ch >= 0x60 && ch <= 0x7f)) ch += 0x40;
	else if (ch >= 0x40 && ch <= 0x5f) ch += 0x80;
	else if (ch >= 0x80 && ch <= 0x9f) ch -= 0x80;
	else if ((ch >= 0xa0 && ch <= 0xbF) || (ch >= 0xd0 && ch <= 0xdf)) ch -= 0x40;
	return ch;
}
#endif // PETSCII_H
