idolpx/meatloaf-archived/(commit log)

2021-03-28 Updated ESP32 PIN assignments
2021-04-03 fix notice and change name of interface.h/cpp
    [iec_device.cpp, iec_device.h]
2021-05-12 track pin mode
2021-05-21 Add optional wiring for SRQ and RESET
2021-05-26 Switched to Debug_print
2021-05-26 Enhanced DATA_STREAM Updated wiring diagram
2021-05-27 Fixed "CD//" to root then "CD_" to back out of URL Adjusted IEC protocol to handle DEVICE NOT FOUND condition
2021-05-27 changed toggleLED to ledToggle
2021-06-01 Adjustments for framework update
2021-06-02 Added platformio.ini.sample Changed drive to media in device_db
2021-06-03 merged into current, compiling
2021-06-03 Revert "merge again"
    This reverts commit 293f01d5d5c2fba1039409752043771e29905ae7.
    [main.cpp]
2021-06-03 Revert "Revert "merge again""
    This reverts commit cdeff6c450c3904605187a1eac9a13404a13591d.
    [main.cpp]
2021-06-04 Cleaned up CD code Added "CD///" to switch directly to root of Flash FS when on a server
2021-06-04 Changed "CD///" to "CD"+Up Arrow on the C64 Added archive to device_db
2021-06-04 Added some default files to data Tweaked URLParser Disabled .URL loader beacuse of issue with WebDAV Modified default setting for archive in device_db Updated .gitignore
2021-06-06 Stage a few more files
2021-06-09 Add schematic to repo (not complete)
    [meatloaf.drive.modem.1.kicad_pcb, meatloaf.drive.modem.1.sch]
2021-06-09 some fixes, commented out test
    [main.cpp]
2021-06-10 more debug
    [meatloaf.drive.modem.1.sch]
2021-06-10 Fix case sensitive scheme matching in MFile
2021-06-12 fix case sensitive c=server scheme detection
2021-06-12 more case sensitive checks
2021-06-13 Started D64 support Made util_starts_with & util_ends_with case insensitive by default
2021-06-13 Add seek(track, sector)
2021-06-15 Added m_device_status to iec_device Modified sendStatus to use this variable Added default power on status
2021-06-16 Disable updating devices.db for now Delete current devices.db after this update
2021-06-17 Compiles with Arduino 3.0 framework now
2021-06-17 Replaced WebDAV with Web Server & hooked WebDAV
    [main.cpp]
2021-06-20 ugh... so annoyed... don't know what I'm doing wrong
    [main.cpp]
2021-06-20 created a prototype IECDevice that will handle MFile and on-the-fly TXT conversion
2021-06-20 added error handling to new IEC device
2021-06-20 added BOM comment
2021-06-20 implemented BOM
2021-06-22 some changes for ESP32
2021-06-22 some more esp32 fixes, commented out unused functions
2021-06-23 Store settings in seperate device files
2021-06-23 Changing up iec_device to track path
2021-06-29 Implement std_stream_wrapper in device_db Trouble shoot assigning std:shared_ptr
2021-06-30 Change device to id in device_db Troubleshooting m_mfile reassignment
2021-07-02 switched shared_ptr to unique_ptr in a few places
2021-07-05 fixed ascii<->petscii, fixed urlfile, many other fixes
    [petscii.h]
2021-07-06 Add CR when sending status Adjust IEC driver
2021-07-09 more fixes to C++ streams
    [ml_tests.cpp]
2021-07-14 Fixed PRINT# issue
2021-07-14 Added statemachine Now using interrupt to detect ATN and service IEC bus
2021-07-16 Tweaks to IEC driver Cleanup & troubleshooting
2021-07-16 Added ArduinoWebsockets to platformio.ini.sample
2021-07-24 Tweaks to IEC driver
2021-07-27 Renamed ML device info stat functions Rearranged iec_device.h
2021-07-27 Added DeviceState enum Added arguments for a few functions
2021-07-29 Added bit flag defines Renamed m_state to flags Adjusted DeviceDB::select()
2021-07-29 Moved PULLED/RELEASED to defines Detects JIFFYDOS Interrupt updates ATN_PULLED flag
2021-10-06 Fix webdav for filenames with spaces More D64 stuff
    [global_defines.h, main.cpp]
2022-02-18 Updated wiring diagram
2022-02-18 Updated wiring diagram again
2022-02-18 Add references to confirm 5v tolerance on I/O pins
2022-02-19 Modified schematics
    [meatloaf.drive.modem.1.kicad_pcb, meatloaf.drive.modem.1.kicad_sch, meatloaf.drive.modem.1.sch]
2022-08-09 Fix ArduinoJson include issue
2022-09-21 Update README.md
    Added link to ESP32 firmware
